marx-merten/sonosremote/(list of files, cad)

Other CAD files:
pcb/GenericEPaperRemote/ss.dxf
