marx-merten/sonosremote/pcb/GenericEPaperRemote/GenericEPaperRemote.kicad_pcb

## KiCad design pcb/GenericEPaperRemote/GenericEPaperRemote.kicad_pcb (2020-12-23)

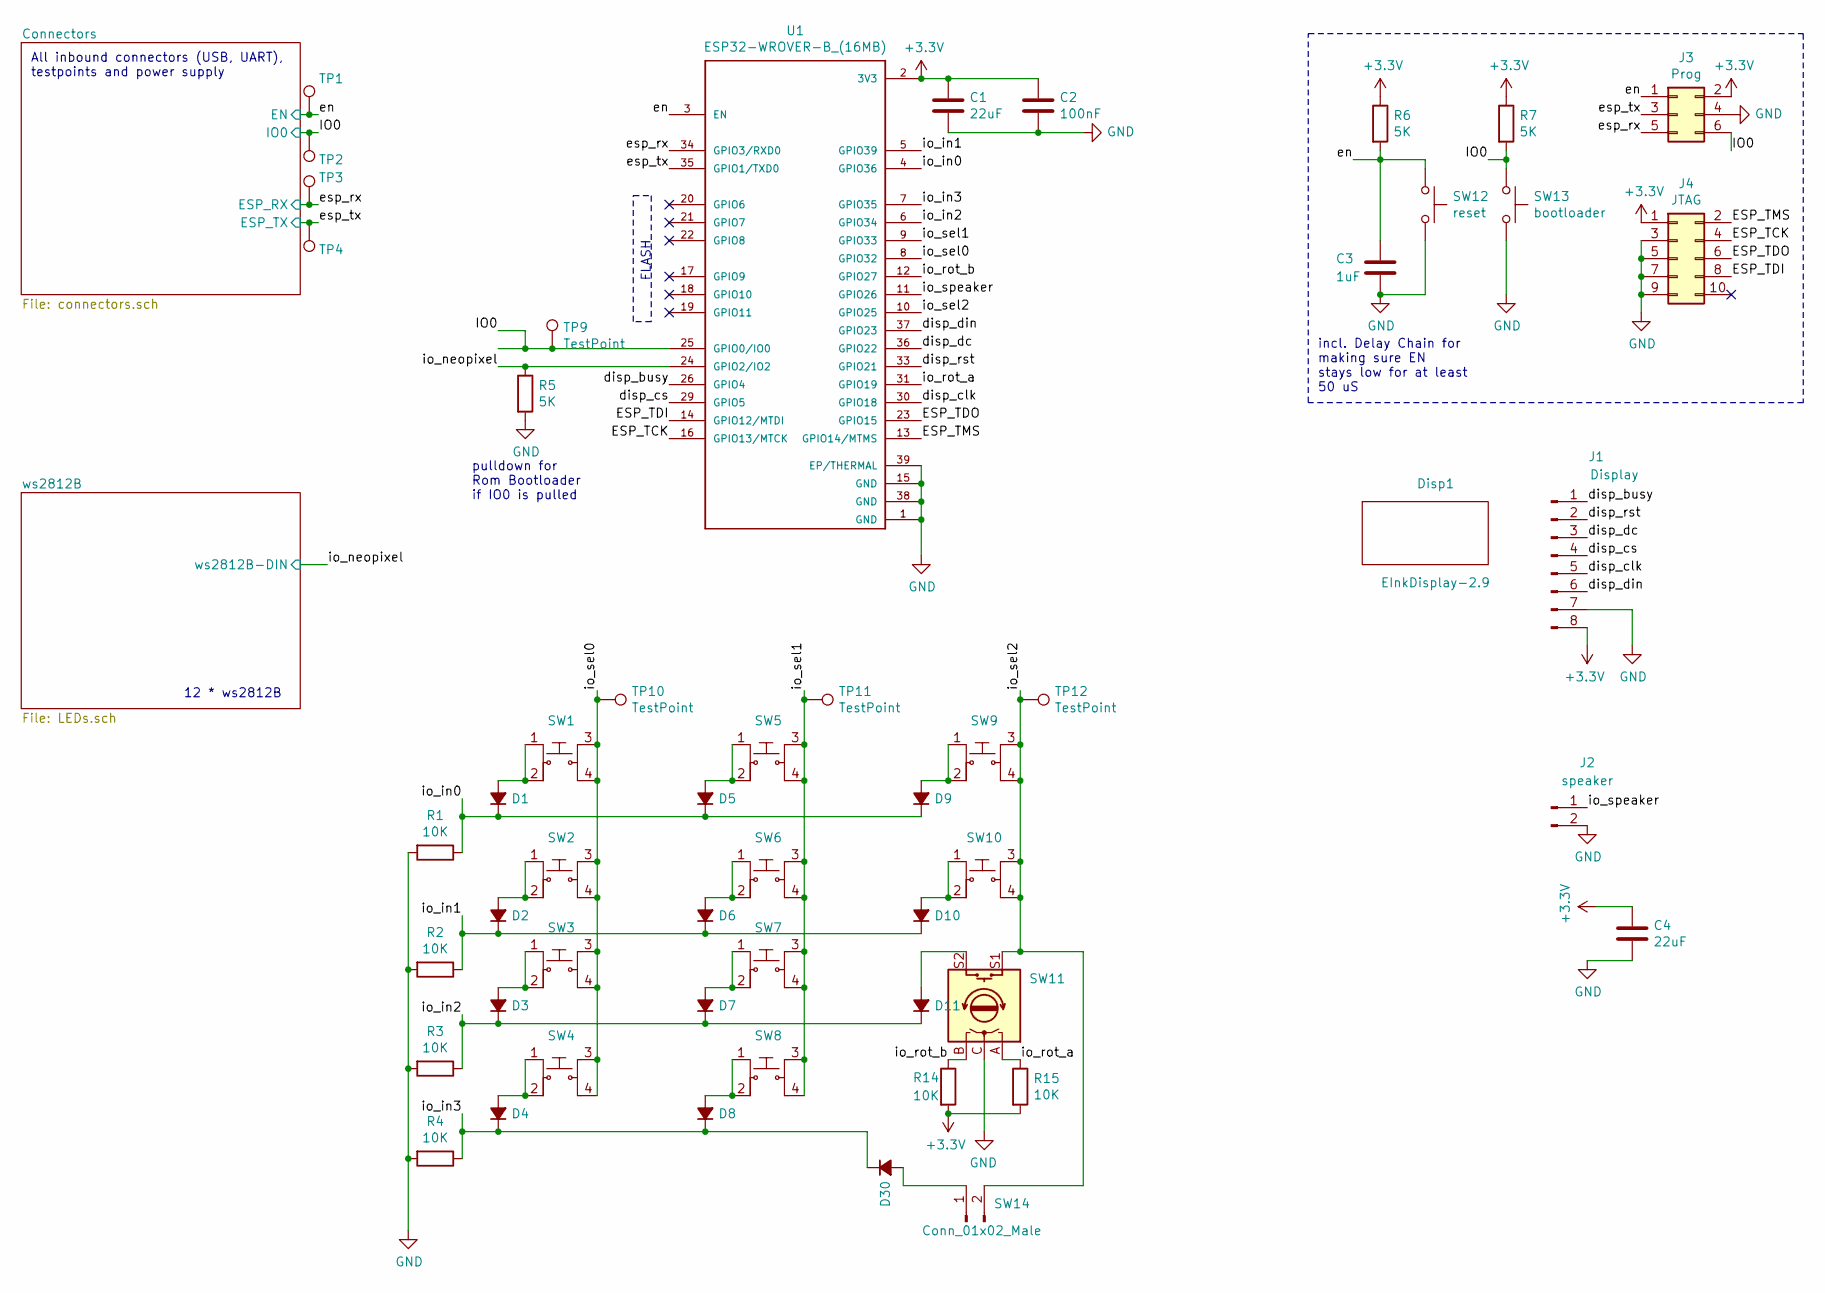
[picture p5: schematic GenericEPaperRemote.sch]

Parts:
C1, C4: 22uF; C_1206_3216Metric_Pad1.42x1.75mm_HandSolder; MPN CL31A226MOCLNNC
C2: 100nF; C_0805_2012Metric_Pad1.15x1.40mm_HandSolder; MPN CL21F104ZBCNNNC
C3: 1uF; C_0805_2012Metric_Pad1.15x1.40mm_HandSolder; MPN CL21B105KBFNNNE
D1, D2, D3, D4, D5, D6, D7, D8, D9, D10, D11, D30: D_Small_ALT; D_SOT-23_ANK; MPN BAV99-7-F
Disp1: EInkDisplay-2.9; EInkDisplay2.9
J1: Display; JST_PH_S8B-PH-SM4-TB_1x08-1MP_P2.00mm_Horizontal
J2: speaker; PinHeader_1x02_P2.54mm_Horizontal
J3: Prog; IDC-Header_2x03_P2.54mm_Vertical; MPN C11214
J4: JTAG; IDC-Header_2x05_P2.54mm_Vertical; MPN C5665
R1, R2, R3, R4, R14, R15: 10K; R_0805_2012Metric_Pad1.15x1.40mm_HandSolder
R5, R6, R7: 5K; R_0805_2012Metric_Pad1.15x1.40mm_HandSolder
SW1, SW2, SW3, SW4, SW5, SW6, SW7, SW8, SW9, SW10: TactileSwitchSMD6x6; Switch_Tactile_SMD_6x6mm; MPN 1TS005F-2500-5001
SW11: Rotary_Encoder_Switch; RotaryEncoder_Alps_EC11E-Switch_Vertical_H20mm
SW12: reset; SW_Push_SPST_NO_Alps_SKRK
SW13: bootloader; SW_Push_SPST_NO_Alps_SKRK
SW14: Conn_01x02_Male; PinHeader_1x02_P2.54mm_Vertical
TP1, TP2, TP3, TP4, TP9, TP10, TP11, TP12: TestPoint; TestPoint_THTPad_2.0x2.0mm_Drill1.0mm
U1: ESP32-WROVER-B_(16MB); XCVR_ESP32-WROVER-B_(16MB)

Connections:
+3V3: C1.1, C2.1, C4.1, J1.8, J3.2, J4.1, R6.1, R7.1, R14.2, R15.2, U1.2 (3V3); also elsewhere on the board
/ESP_TCK: J4.4, U1.16 (GPIO13/MTCK)
/ESP_TDI: J4.8, U1.14 (GPIO12/MTDI)
/ESP_TDO: J4.6, U1.23 (GPIO15)
/ESP_TMS: J4.2, U1.13 (GPIO14/MTMS)
/IO0: J3.6, R7.2, SW13.1, TP2.1, TP9.1, U1.25 (GPIO0/IO0); also elsewhere on the board
/disp_busy: J1.1, U1.26 (GPIO4)
/disp_clk: J1.5, U1.30 (GPIO18)
/disp_cs: J1.4, U1.29 (GPIO5)
/disp_dc: J1.3, U1.36 (GPIO22)
/disp_din: J1.6, U1.37 (GPIO23)
/disp_rst: J1.2, U1.33 (GPIO21)
/en: C3.1, J3.1, R6.2, SW12.1, TP1.1, U1.3 (EN); also elsewhere on the board
/esp_rx: J3.5, TP3.1, U1.34 (GPIO3/RXD0); also elsewhere on the board
/esp_tx: J3.3, TP4.1, U1.35 (GPIO1/TXD0); also elsewhere on the board
/io_in0: D1.1 (K), D5.1 (K), D9.1 (K), R1.1, U1.4 (GPIO36)
/io_in1: D2.1 (K), D6.1 (K), D10.1 (K), R2.1, U1.5 (GPIO39)
/io_in2: D3.1 (K), D7.1 (K), D11.1 (K), R3.1, U1.6 (GPIO34)
/io_in3: D4.1 (K), D8.1 (K), D30.1 (K), R4.1, U1.7 (GPIO35)
/io_neopixel: R5.1, U1.24 (GPIO2/IO2); also elsewhere on the board
/io_rot_a: R15.1, SW11.A, U1.31 (GPIO19)
/io_rot_b: R14.1, SW11.B, U1.12 (GPIO27)
/io_sel0: SW1.3, SW1.4, SW2.3, SW2.4, SW3.3, SW3.4, SW4.3, SW4.4, TP10.1, U1.8 (GPIO32)
/io_sel1: SW5.3, SW5.4, SW6.3, SW6.4, SW7.3, SW7.4, SW8.3, SW8.4, TP11.1, U1.9 (GPIO33)
/io_sel2: SW9.3, SW9.4, SW10.3, SW10.4, SW11.S1, SW14.2, TP12.1, U1.10 (GPIO25)
/io_speaker: J2.1, U1.11 (GPIO26)
GND: C1.2, C2.2, C3.2, C4.2, J1.7, J2.2, J3.4, J4.3, J4.5, J4.7, J4.9, R1.2, R2.2, R3.2, R4.2, R5.2, SW11.C, SW12.2, SW13.2, U1.1 (GND), U1.15 (GND), U1.38 (GND), U1.39 (EP/THERMAL); also elsewhere on the board
unnamed: D1.2 (A), SW1.1, SW1.2
unnamed: D2.2 (A), SW2.1, SW2.2
unnamed: D3.2 (A), SW3.1, SW3.2
unnamed: D4.2 (A), SW4.1, SW4.2
unnamed: D5.2 (A), SW5.1, SW5.2
unnamed: D6.2 (A), SW6.1, SW6.2
unnamed: D7.2 (A), SW7.1, SW7.2
unnamed: D8.2 (A), SW8.1, SW8.2
unnamed: D9.2 (A), SW9.1, SW9.2
unnamed: D10.2 (A), SW10.1, SW10.2
unnamed: D11.2 (A), SW11.S2
unnamed: D30.2 (A), SW14.1

Notes on the sheet:
All inbound connectors (USB, UART), testpoints and power supply
incl. Delay Chain for making sure EN stays low for at least 50 uS
pulldown for Rom Bootloader if IO0 is pulled
FLASH
12 * ws2812B

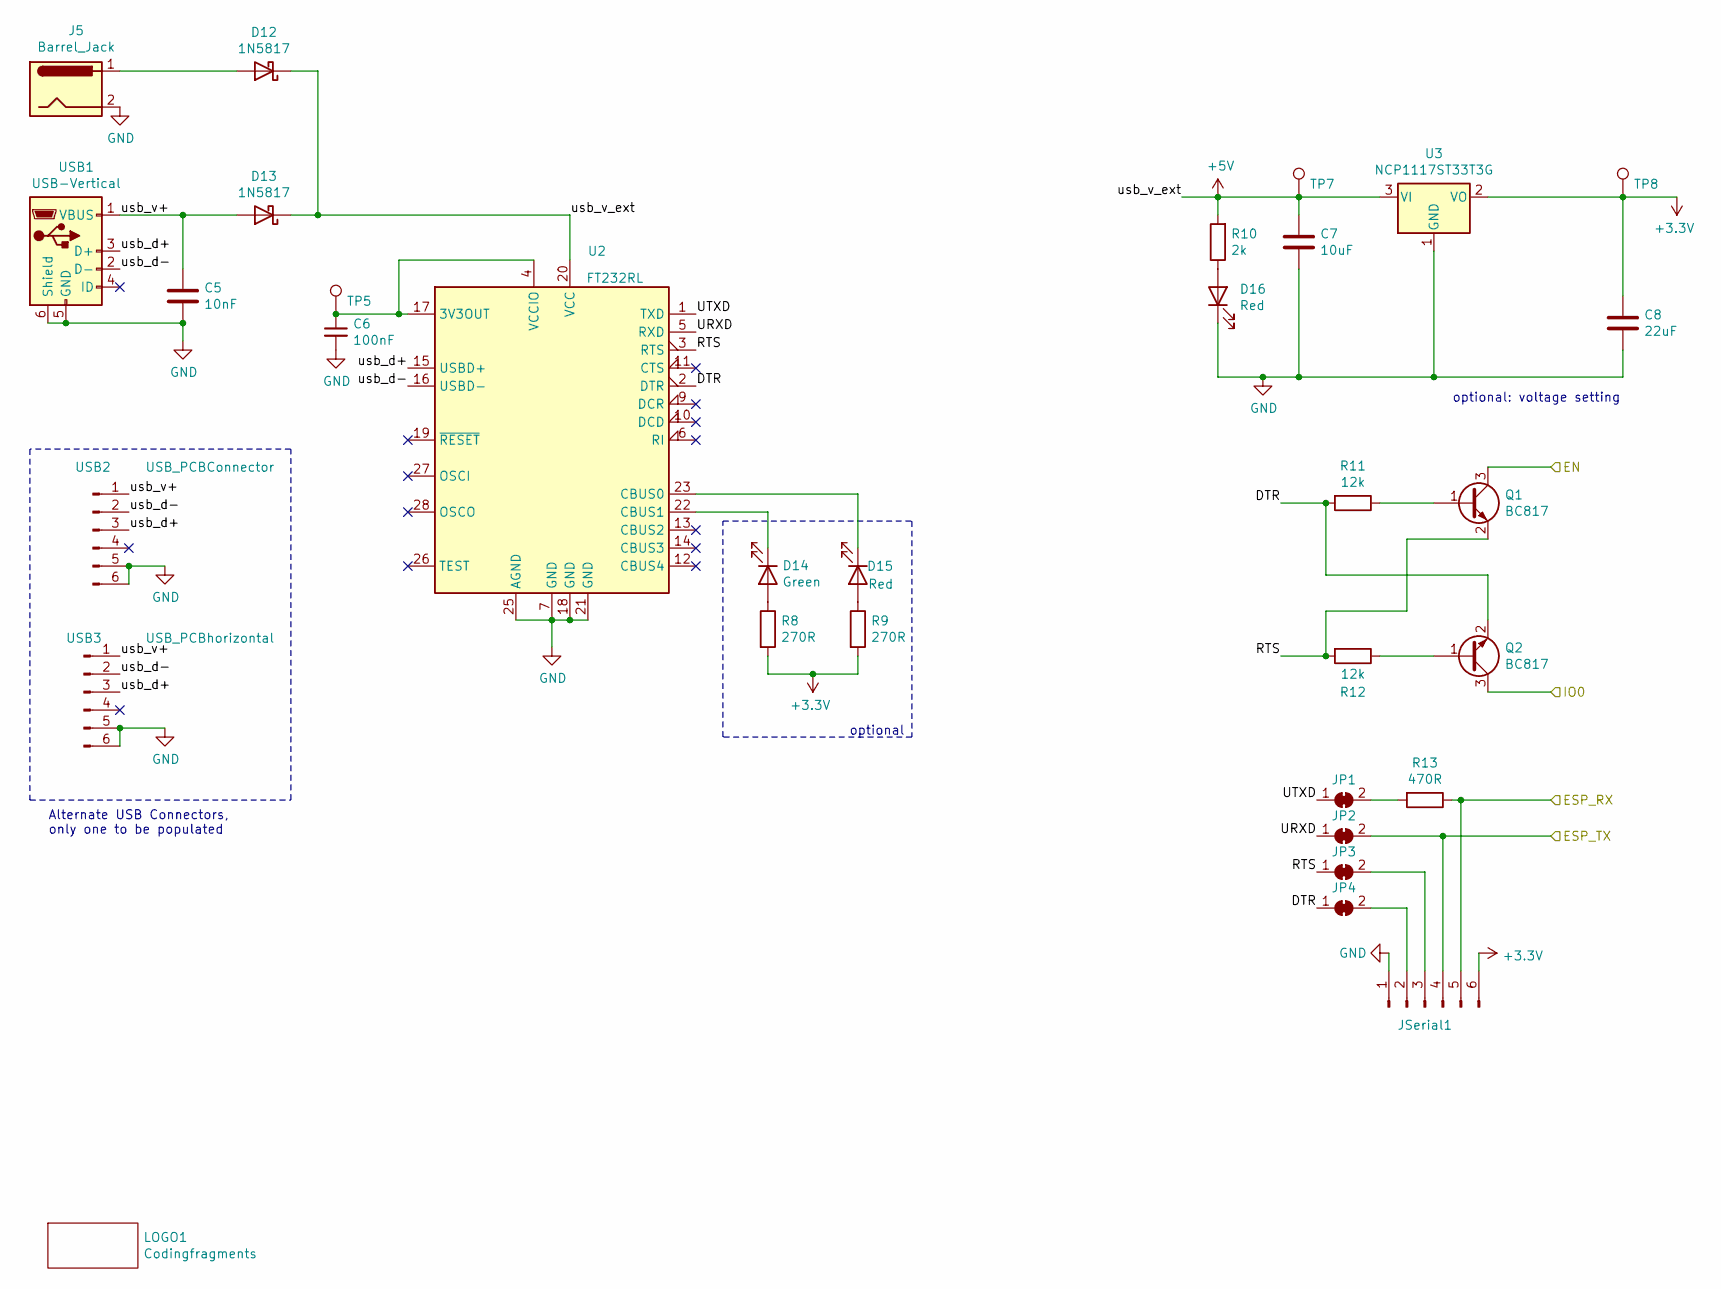
[picture p6: schematic connectors.sch]

Parts:
C5: 10nF; C_0805_2012Metric_Pad1.15x1.40mm_HandSolder; MPN CL21B103KBCNNNC
C6: 100nF; C_0805_2012Metric_Pad1.15x1.40mm_HandSolder; MPN CL21F104ZBCNNNC
C7: 10uF; C_1206_3216Metric_Pad1.42x1.75mm_HandSolder; MPN CL31F106ZPENNNE
C8: 22uF; C_1206_3216Metric_Pad1.42x1.75mm_HandSolder; MPN CL31A226MOCLNNC
D12, D13: 1N5817; D_SMB_Handsoldering
D14: Green; LED_1206_3216Metric_Pad1.42x1.75mm_HandSolder; MPN TJ-S3216SW9TGLC2G-A5
D15, D16: Red; LED_1206_3216Metric_Pad1.42x1.75mm_HandSolder; MPN TJ-S3216SW9TGLC2R-A5
J5: Barrel_Jack; BarrelJack_CUI_PJ-063AH_Horizontal
JP1, JP2, JP3, JP4: SolderJumper_2_Bridged; SolderJumper-2_P1.3mm_Bridged_RoundedPad1.0x1.5mm
JSerial1: Conn_01x06_Male; PinHeader_1x06_P2.54mm_Horizontal; MPN PZ254R-11-06P
LOGO1: Codingfragments; OSSLogo
Q1, Q2: BC817; SOT-23; MPN BC817-25LT1G
R8, R9: 270R; R_0805_2012Metric_Pad1.15x1.40mm_HandSolder
R10: 2k; R_0805_2012Metric_Pad1.15x1.40mm_HandSolder
R11, R12: 12k; R_0805_2012Metric_Pad1.15x1.40mm_HandSolder
R13: 470R; R_0805_2012Metric_Pad1.15x1.40mm_HandSolder
TP5, TP7, TP8: TestPoint; TestPoint_THTPad_2.0x2.0mm_Drill1.0mm
U2: FT232RL; SSOP-28_5.3x10.2mm_P0.65mm
U3: NCP1117ST33T3G; SOT-223-3_TabPin2; MPN NCP1117ST33T3G
USB1: USB-Vertical; USB_Micro-B_Molex-105133-0031
USB2: USB_PCBConnector; PinHeader_1x06_P2.54mm_Vertical
USB3: USB_PCBhorizontal; USB_Micro-B_Molex_47346-0001

Connections:
+3V3: C8.1, JSerial1.6, R8.2, R9.2, TP8.1, U3.2 (VO); also elsewhere on the board
+5V: C7.1, D12.1 (K), D13.1 (K), R10.2, TP7.1, U2.20 (VCC), U3.3 (VI); also elsewhere on the board
/Connectors/DTR: JP4.1 (A), Q2.2 (E), R11.2, U2.2 (DTR)
/Connectors/RTS: JP3.1 (A), Q1.2 (E), R12.2, U2.3 (RTS)
/Connectors/URXD: JP2.1 (A), U2.5 (RXD)
/Connectors/UTXD: JP1.1 (A), U2.1 (TXD)
/Connectors/usb_d+: U2.15 (USBD+), USB1.3 (D+), USB2.3, USB3.3
/Connectors/usb_d-: U2.16 (USBD-), USB1.2 (D-), USB2.2, USB3.2
/Connectors/usb_v+: C5.1, D13.2 (A), USB1.1 (VBUS), USB2.1, USB3.1
/IO0: Q2.3 (C); also elsewhere on the board
/en: Q1.3 (C); also elsewhere on the board
/esp_rx: JSerial1.5, R13.1; also elsewhere on the board
/esp_tx: JP2.2 (B), JSerial1.4; also elsewhere on the board
GND: C5.2, C6.2, C7.2, C8.2, D16.1 (K), J5.2, JSerial1.1, U2.7 (GND), U2.18 (GND), U2.21 (GND), U2.25 (AGND), U3.1 (GND), USB1.5 (GND), USB1.6 (Shield), USB2.5, USB2.6, USB3.5, USB3.6; also elsewhere on the board
unnamed: C6.1, TP5.1, U2.4 (VCCIO), U2.17 (3V3OUT)
unnamed: D12.2 (A), J5.1
unnamed: D14.1 (K), U2.22 (CBUS1)
unnamed: D14.2 (A), R8.1
unnamed: D15.1 (K), U2.23 (CBUS0)
unnamed: D15.2 (A), R9.1
unnamed: D16.2 (A), R10.1
unnamed: JP1.2 (B), R13.2
unnamed: JP3.2 (B), JSerial1.3
unnamed: JP4.2 (B), JSerial1.2
unnamed: Q1.1 (B), R11.1
unnamed: Q2.1 (B), R12.1

Notes on the sheet:
Alternate USB Connectors, only one to be populated
optional
optional: voltage setting

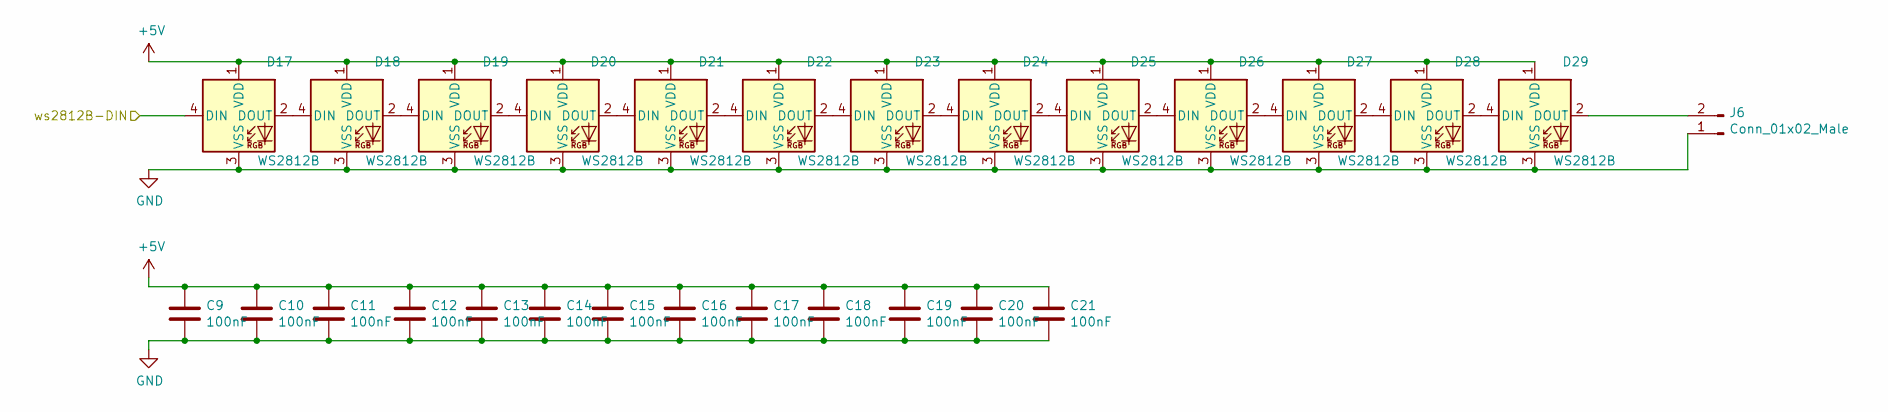
[picture p7: schematic LEDs.sch]

Parts:
C9, C10, C11, C12, C13, C14, C15, C16, C17, C18, C19, C20, C21: 100nF; C_0805_2012Metric_Pad1.15x1.40mm_HandSolder; MPN CL21F104ZBCNNNC
D17, D18, D19, D20, D21, D22, D23, D24, D25, D26, D27, D28, D29: WS2812B; LED_WS2812B_PLCC4_5.0x5.0mm_P3.2mm; MPN WS2812B-B
J6: Conn_01x02_Male; PinHeader_1x02_P2.54mm_Vertical

Connections:
+5V: C9.1, C10.1, C11.1, C12.1, C13.1, C14.1, C15.1, C16.1, C17.1, C18.1, C19.1, C20.1, C21.1, D17.1 (VDD), D18.1 (VDD), D19.1 (VDD), D20.1 (VDD), D21.1 (VDD), D22.1 (VDD), D23.1 (VDD), D24.1 (VDD), D25.1 (VDD), D26.1 (VDD), D27.1 (VDD), D28.1 (VDD), D29.1 (VDD); also elsewhere on the board
/io_neopixel: D17.4 (DIN); also elsewhere on the board
GND: C9.2, C10.2, C11.2, C12.2, C13.2, C14.2, C15.2, C16.2, C17.2, C18.2, C19.2, C20.2, C21.2, D17.3 (VSS), D18.3 (VSS), D19.3 (VSS), D20.3 (VSS), D21.3 (VSS), D22.3 (VSS), D23.3 (VSS), D24.3 (VSS), D25.3 (VSS), D26.3 (VSS), D27.3 (VSS), D28.3 (VSS), D29.3 (VSS), J6.1; also elsewhere on the board
unnamed: D17.2 (DOUT), D18.4 (DIN)
unnamed: D18.2 (DOUT), D19.4 (DIN)
unnamed: D19.2 (DOUT), D20.4 (DIN)
unnamed: D20.2 (DOUT), D21.4 (DIN)
unnamed: D21.2 (DOUT), D22.4 (DIN)
unnamed: D22.2 (DOUT), D23.4 (DIN)
unnamed: D23.2 (DOUT), D24.4 (DIN)
unnamed: D24.2 (DOUT), D25.4 (DIN)
unnamed: D25.2 (DOUT), D26.4 (DIN)
unnamed: D26.2 (DOUT), D27.4 (DIN)
unnamed: D27.2 (DOUT), D28.4 (DIN)
unnamed: D28.2 (DOUT), D29.4 (DIN)
unnamed: D29.2 (DOUT), J6.2

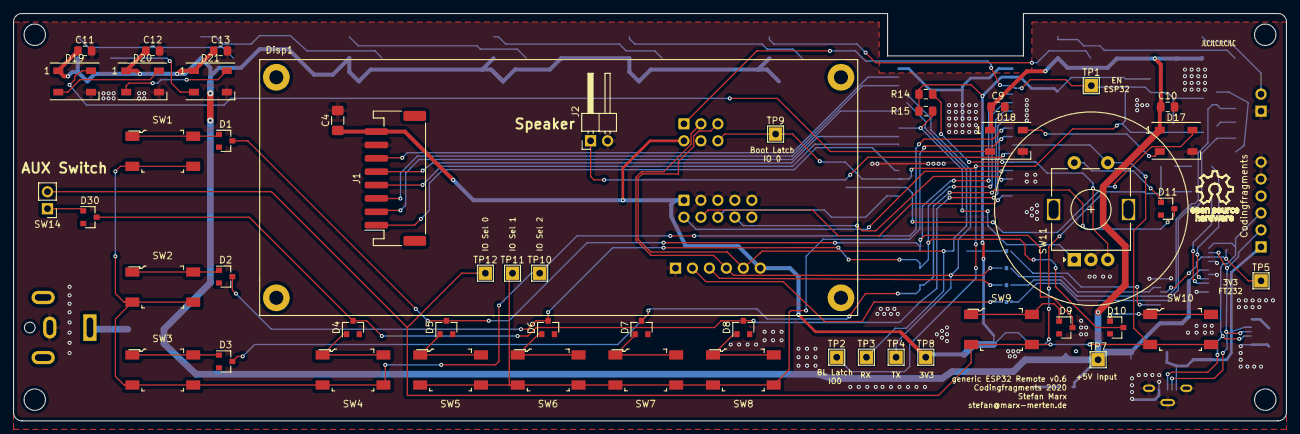
[picture p8: board GenericEPaperRemote.kicad_pcb from above]

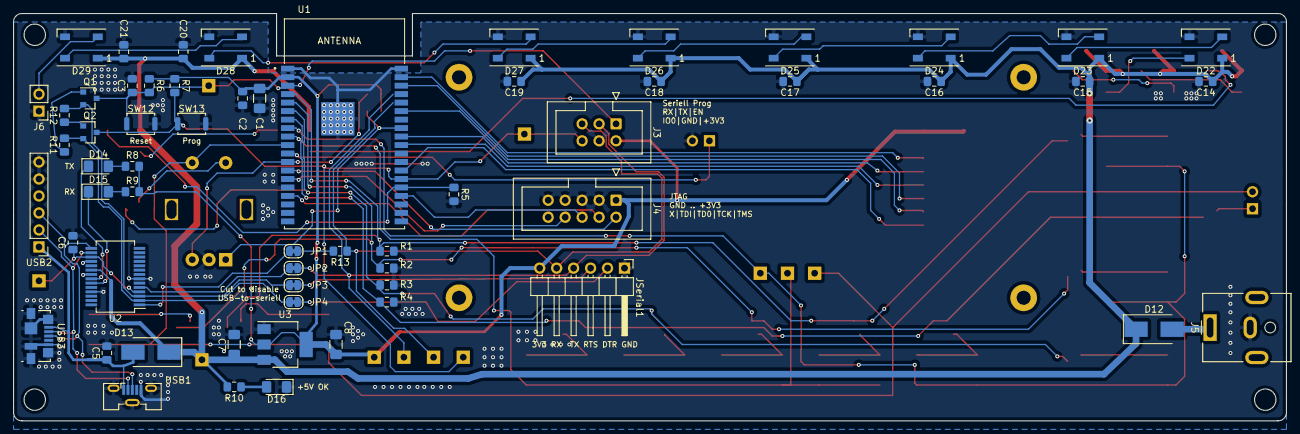
[picture p9: board GenericEPaperRemote.kicad_pcb from below]

Board: 2 copper layers, 190.5 x 61.0 mm, 112 parts (60 on the bottom side), 72 nets.
