marx-merten/sonosremote/(commit log)

2020-10-25 initial pcb
    [GenericEPaperRemote.kicad_pcb, GenericEPaperRemote.sch, LEDs.sch, connectors.sch]
2020-10-25 Finalize first version of pcb
    [GenericEPaperRemote.kicad_pcb]
2020-10-25 small changes
    [GenericEPaperRemote.kicad_pcb]
2020-11-09 Added pullups for encoder and switch away from io0 to prevent boot to root-loader when rotary encoder pulls low)
    [GenericEPaperRemote-B_Mask.gbr, GenericEPaperRemote-B_Paste.gbr, GenericEPaperRemote-B_SilkS.gbr, GenericEPaperRemote-Back.gbr, GenericEPaperRemote-Edge_Cuts.gbr, GenericEPaperRemote-F_Mask.gbr, GenericEPaperRemote-F_Paste.gbr, GenericEPaperRemote-F_SilkS.gbr]
2020-11-18 Added ESP32 Board Definition
2020-11-18 Added Stubs local samples dir
2020-11-18 Micropython build config
    [partitions-remote-py.csv]
2020-11-18 Added epaper driver from MCauser
2020-11-18 esp32 board tests
2020-11-21 added rotary encoder setup
2020-11-21 simple audio buzzer test
    [mario.py]
2020-11-22 logging base framework
2020-11-30 added base led mood support
2020-11-30 add loop() for reentering execution loop and fade out led for status bar
2020-11-30 move main reporting to log framework and move led tests to seperate file structure with reentry capable methods
2020-11-30 moved boot logging to logging framework
2020-11-30 added extension pins for ws2812b
    [GenericEPaperRemote.kicad_pcb, LEDs.sch]
2020-12-23 added aux ws2812B Socket (J6)
    [GenericEPaperRemote.kicad_pcb]
